sintech/Flip-Dot-Display/(threads)

Thread 1 (2021-03-11):

BAV99 проблема с частями на схеме

Assamber, 2021-03-11:
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

Если обратить внимание на подписи пинов у диодов на схеме, то можно заметить проблему. Пин номер 3 у части A и B один и тот же. На схеме соединяется пины 1 и 2. Получается, что два диода соединяются паралелльно и на встречу друг другу. Смысл этих диодов тогда пропадает. Подозреваю, что на схеме третий пин должен быть подключен к индуктивности.

sintech, 2021-03-12:
Спасибо, исправил в a9cf7c198e970c73305a8bcc1b656d7e699d6c1c
В kicad библиотеках как раз обновилось УГО для BAV99.

Closed 2021-03-12.
