sintech/Flip-Dot-Display/schematics/Flip-dot_part.sch

## KiCad design schematics/Flip-dot_part.sch (2021-03-12)

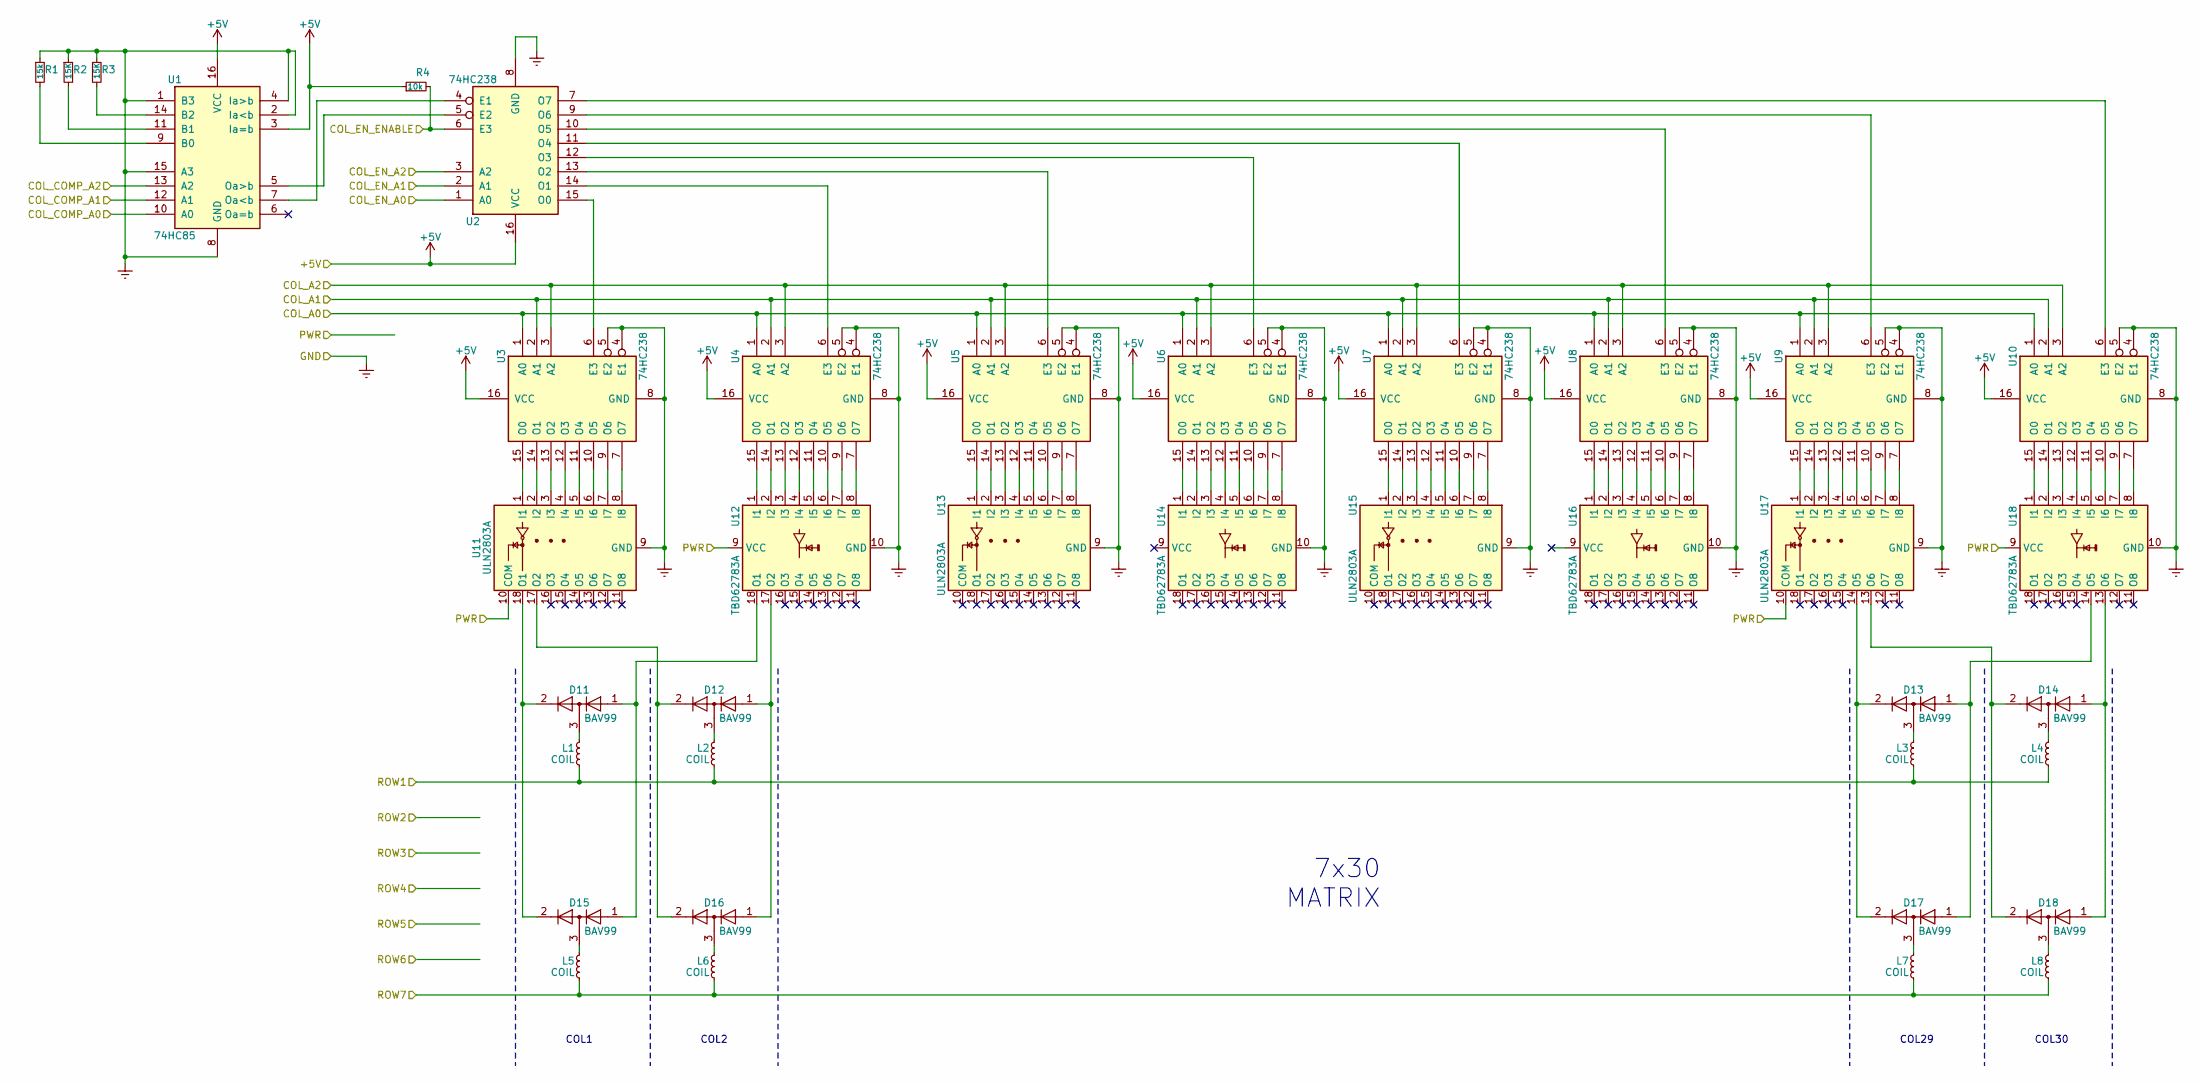
[picture p6: schematic Flip-dot_part.sch]

Parts:
D11, D12, D13, D14, D15, D16, D17, D18: BAV99; SOT-23
L1, L2, L3, L4, L5, L6, L7, L8: COIL
R1: 15k
R2, R3: 15K
R4: 10k
U1: 74HC85
U2, U3, U4, U5, U6, U7, U8, U9, U10: 74HC238
U11, U13, U15, U17: ULN2803A
U12, U14, U16, U18: TBD62783A

Connections:
+5V: R4.1, U1.3 (Ia=b), U1.16 (VCC), U2.16 (VCC), U3.16 (VCC), U4.16 (VCC), U5.16 (VCC), U6.16 (VCC), U7.16 (VCC), U8.16 (VCC), U9.16 (VCC), U10.16 (VCC)
COL_A0: U3.1 (A0), U4.1 (A0), U5.1 (A0), U6.1 (A0), U7.1 (A0), U8.1 (A0), U9.1 (A0), U10.1 (A0)
COL_A1: U3.2 (A1), U4.2 (A1), U5.2 (A1), U6.2 (A1), U7.2 (A1), U8.2 (A1), U9.2 (A1), U10.2 (A1)
COL_A2: U3.3 (A2), U4.3 (A2), U5.3 (A2), U6.3 (A2), U7.3 (A2), U8.3 (A2), U9.3 (A2), U10.3 (A2)
COL_COMP_A0: U1.10 (A0)
COL_COMP_A1: U1.12 (A1)
COL_COMP_A2: U1.13 (A2)
COL_EN_A0: U2.1 (A0)
COL_EN_A1: U2.2 (A1)
COL_EN_A2: U2.3 (A2)
COL_EN_ENABLE: R4.2, U2.6 (E3)
Earth: R1.1, R2.1, R3.1, U1.1 (B3), U1.2 (Ia<b), U1.4 (Ia>b), U1.8 (GND), U1.15 (A3), U2.8 (GND), U3.4 (E1), U3.5 (E2), U3.8 (GND), U4.4 (E1), U4.5 (E2), U4.8 (GND), U5.4 (E1), U5.5 (E2), U5.8 (GND), U6.4 (E1), U6.5 (E2), U6.8 (GND), U7.4 (E1), U7.5 (E2), U7.8 (GND), U8.4 (E1), U8.5 (E2), U8.8 (GND), U9.4 (E1), U9.5 (E2), U9.8 (GND), U10.4 (E1), U10.5 (E2), U10.8 (GND), U11.9 (GND), U12.10 (GND), U13.9 (GND), U14.10 (GND), U15.9 (GND), U16.10 (GND), U17.9 (GND), U18.10 (GND)
unnamed: D11.1 (K), D15.1 (K), U12.18 (O1)
unnamed: D11.2 (A), D15.2 (A), U11.18 (O1)
unnamed: D11.3 (K), L1.1
unnamed: D12.1 (K), D16.1 (K), U12.17 (O2)
unnamed: D12.2 (A), D16.2 (A), U11.17 (O2)
unnamed: D12.3 (K), L2.1
unnamed: D13.1 (K), D17.1 (K), U18.14 (O5)
unnamed: D13.2 (A), D17.2 (A), U17.14 (O5)
unnamed: D13.3 (K), L3.1
unnamed: D14.1 (K), D18.1 (K), U18.13 (O6)
unnamed: D14.2 (A), D18.2 (A), U17.13 (O6)
unnamed: D14.3 (K), L4.1
unnamed: D15.3 (K), L5.1
unnamed: D16.3 (K), L6.1
unnamed: D17.3 (K), L7.1
unnamed: D18.3 (K), L8.1
unnamed: R1.2, U1.9 (B0)
unnamed: R2.2, U1.11 (B1)
unnamed: R3.2, U1.14 (B2)
unnamed: U1.5 (Oa>b), U2.5 (E2)
unnamed: U1.7 (Oa<b), U2.4 (E1)
unnamed: U2.9 (O6), U9.6 (E3)
unnamed: U2.10 (O5), U8.6 (E3)
unnamed: U2.11 (O4), U7.6 (E3)
unnamed: U2.12 (O3), U6.6 (E3)
unnamed: U2.13 (O2), U5.6 (E3)
unnamed: U2.14 (O1), U4.6 (E3)
unnamed: U2.15 (O0), U3.6 (E3)
unnamed: U2.7 (O7), U10.6 (E3)
unnamed: U10.7 (O7), U18.8 (I8)
unnamed: U10.9 (O6), U18.7 (I7)
unnamed: U10.10 (O5), U18.6 (I6)
unnamed: U10.11 (O4), U18.5 (I5)
unnamed: U10.12 (O3), U18.4 (I4)
unnamed: U10.13 (O2), U18.3 (I3)
unnamed: U10.14 (O1), U18.2 (I2)
unnamed: U10.15 (O0), U18.1 (I1)
unnamed: U3.15 (O0), U11.1 (I1)
unnamed: U3.14 (O1), U11.2 (I2)
unnamed: U3.13 (O2), U11.3 (I3)
unnamed: U3.12 (O3), U11.4 (I4)
unnamed: U3.11 (O4), U11.5 (I5)
unnamed: U3.10 (O5), U11.6 (I6)
unnamed: U3.9 (O6), U11.7 (I7)
unnamed: U3.7 (O7), U11.8 (I8)
unnamed: U4.15 (O0), U12.1 (I1)
unnamed: U4.14 (O1), U12.2 (I2)
unnamed: U4.13 (O2), U12.3 (I3)
unnamed: U4.12 (O3), U12.4 (I4)
unnamed: U4.11 (O4), U12.5 (I5)
unnamed: U4.10 (O5), U12.6 (I6)
unnamed: U4.9 (O6), U12.7 (I7)
unnamed: U4.7 (O7), U12.8 (I8)
unnamed: U5.15 (O0), U13.1 (I1)
unnamed: U5.14 (O1), U13.2 (I2)
unnamed: U5.13 (O2), U13.3 (I3)
unnamed: U5.12 (O3), U13.4 (I4)
unnamed: U5.11 (O4), U13.5 (I5)
unnamed: U5.10 (O5), U13.6 (I6)
unnamed: U5.9 (O6), U13.7 (I7)
unnamed: U5.7 (O7), U13.8 (I8)
unnamed: U6.15 (O0), U14.1 (I1)
unnamed: U6.14 (O1), U14.2 (I2)
unnamed: U6.13 (O2), U14.3 (I3)
unnamed: U6.12 (O3), U14.4 (I4)
unnamed: U6.11 (O4), U14.5 (I5)
unnamed: U6.10 (O5), U14.6 (I6)
unnamed: U6.9 (O6), U14.7 (I7)
unnamed: U6.7 (O7), U14.8 (I8)
unnamed: U7.15 (O0), U15.1 (I1)
unnamed: U7.14 (O1), U15.2 (I2)
unnamed: U7.13 (O2), U15.3 (I3)
unnamed: U7.12 (O3), U15.4 (I4)
unnamed: U7.11 (O4), U15.5 (I5)
unnamed: U7.10 (O5), U15.6 (I6)
unnamed: U7.9 (O6), U15.7 (I7)
unnamed: U7.7 (O7), U15.8 (I8)
unnamed: U8.15 (O0), U16.1 (I1)
unnamed: U8.14 (O1), U16.2 (I2)
unnamed: U8.13 (O2), U16.3 (I3)
unnamed: U8.12 (O3), U16.4 (I4)
unnamed: U8.11 (O4), U16.5 (I5)
unnamed: U8.10 (O5), U16.6 (I6)
unnamed: U8.9 (O6), U16.7 (I7)
unnamed: U8.7 (O7), U16.8 (I8)
unnamed: U9.15 (O0), U17.1 (I1)
unnamed: U9.14 (O1), U17.2 (I2)
unnamed: U9.13 (O2), U17.3 (I3)
unnamed: U9.12 (O3), U17.4 (I4)
unnamed: U9.11 (O4), U17.5 (I5)
unnamed: U9.10 (O5), U17.6 (I6)
unnamed: U9.9 (O6), U17.7 (I7)
unnamed: U9.7 (O7), U17.8 (I8)
PWR: U11.10 (COM), U12.9 (VCC), U17.10 (COM), U18.9 (VCC)
ROW1: L1.2, L2.2, L3.2, L4.2
ROW7: L5.2, L6.2, L7.2, L8.2

Notes on the sheet:
COL1
COL2
7x30 MATRIX
COL29
COL30
