sintech/Flip-Dot-Display/schematics/LED_part.sch

## KiCad design schematics/LED_part.sch (2019-05-02)

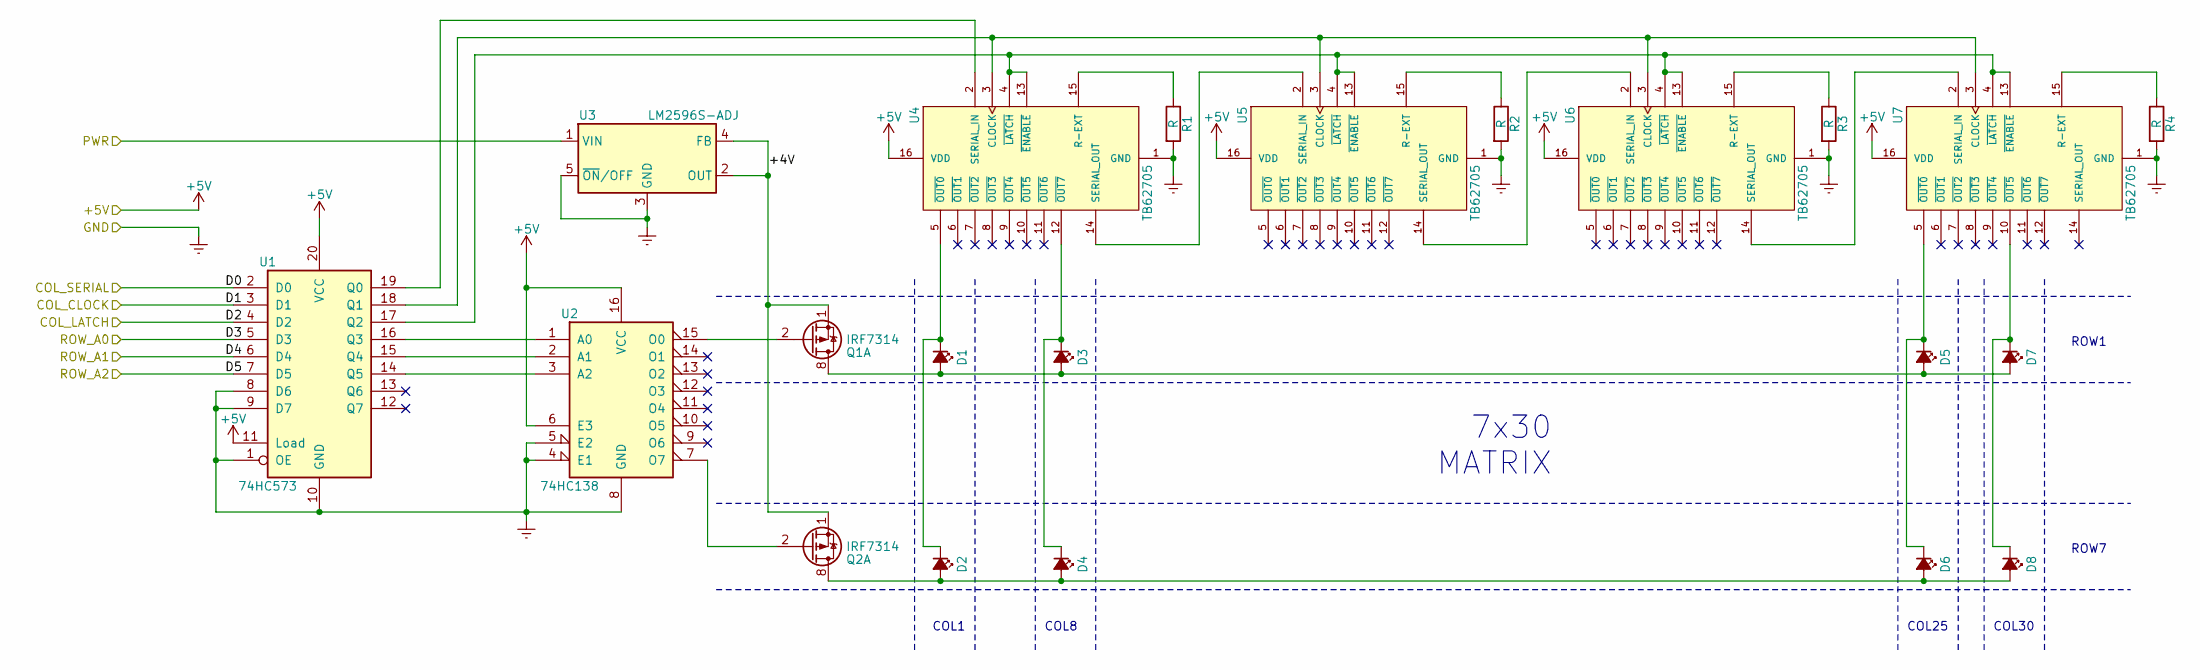
[picture p7: schematic LED_part.sch]

Parts:
D1, D2, D3, D4, D5, D6, D7, D8: LED_Small_ALT
Q1, Q2: IRF7314; SOIC-8_3.9x4.9mm_P1.27mm
R1, R2, R3, R4: R
U1: 74HC573
U2: 74HC138
U3: LM2596S-ADJ; TO-263-5_TabPin3
U4, U5, U6, U7: TB62705

Connections:
+4V: Q1.1 (S1), Q2.1 (S1), U3.2 (OUT), U3.4 (FB)
+5V: U1.11 (Load), U1.20 (VCC), U2.6 (E3), U2.16 (VCC), U4.16 (VDD), U5.16 (VDD), U6.16 (VDD), U7.16 (VDD)
COL_CLOCK: U1.3 (D1)
COL_LATCH: U1.4 (D2)
COL_SERIAL: U1.2 (D0)
D3: U1.5 (D3)
D4: U1.6 (D4)
D5: U1.7 (D5)
Earth: R1.2, R2.2, R3.2, R4.2, U1.1 (OE), U1.8 (D6), U1.9 (D7), U1.10 (GND), U2.4 (E1), U2.5 (E2), U2.8 (GND), U3.3 (GND), U3.5 (~ON~/OFF), U4.1 (GND), U5.1 (GND), U6.1 (GND), U7.1 (GND)
unnamed: D1.1 (K), D2.1 (K), U4.5 (~OUT0)
unnamed: D1.2 (A), D3.2 (A), D5.2 (A), D7.2 (A), Q1.7 (D1), Q1.8 (D1)
unnamed: D2.2 (A), D4.2 (A), D6.2 (A), D8.2 (A), Q2.7 (D1), Q2.8 (D1)
unnamed: D3.1 (K), D4.1 (K), U4.12 (~OUT7)
unnamed: D5.1 (K), D6.1 (K), U7.5 (~OUT0)
unnamed: D7.1 (K), D8.1 (K), U7.10 (~OUT5)
unnamed: Q1.2 (G1), U2.15 (O0)
unnamed: Q2.2 (G1), U2.7 (O7)
unnamed: R1.1, U4.15 (R-EXT)
unnamed: R2.1, U5.15 (R-EXT)
unnamed: R3.1, U6.15 (R-EXT)
unnamed: R4.1, U7.15 (R-EXT)
unnamed: U1.14 (Q5), U2.3 (A2)
unnamed: U1.15 (Q4), U2.2 (A1)
unnamed: U1.16 (Q3), U2.1 (A0)
unnamed: U1.17 (Q2), U4.4 (~LATCH), U4.13 (~ENABLE), U5.4 (~LATCH), U5.13 (~ENABLE), U6.4 (~LATCH), U6.13 (~ENABLE), U7.4 (~LATCH), U7.13 (~ENABLE)
unnamed: U1.18 (Q1), U4.3 (CLOCK), U5.3 (CLOCK), U6.3 (CLOCK), U7.3 (CLOCK)
unnamed: U1.19 (Q0), U4.2 (SERIAL_IN)
unnamed: U4.14 (SERIAL_OUT), U5.2 (SERIAL_IN)
unnamed: U5.14 (SERIAL_OUT), U6.2 (SERIAL_IN)
unnamed: U6.14 (SERIAL_OUT), U7.2 (SERIAL_IN)
PWR: U3.1 (VIN)

Notes on the sheet:
7x30 MATRIX
COL8
COL25
ROW7
ROW1
COL30
COL1
