sintech/Flip-Dot-Display/schematics/flipdotDisplay_adapter.sch

## KiCad design schematics/flipdotDisplay_adapter.sch (2019-05-02)

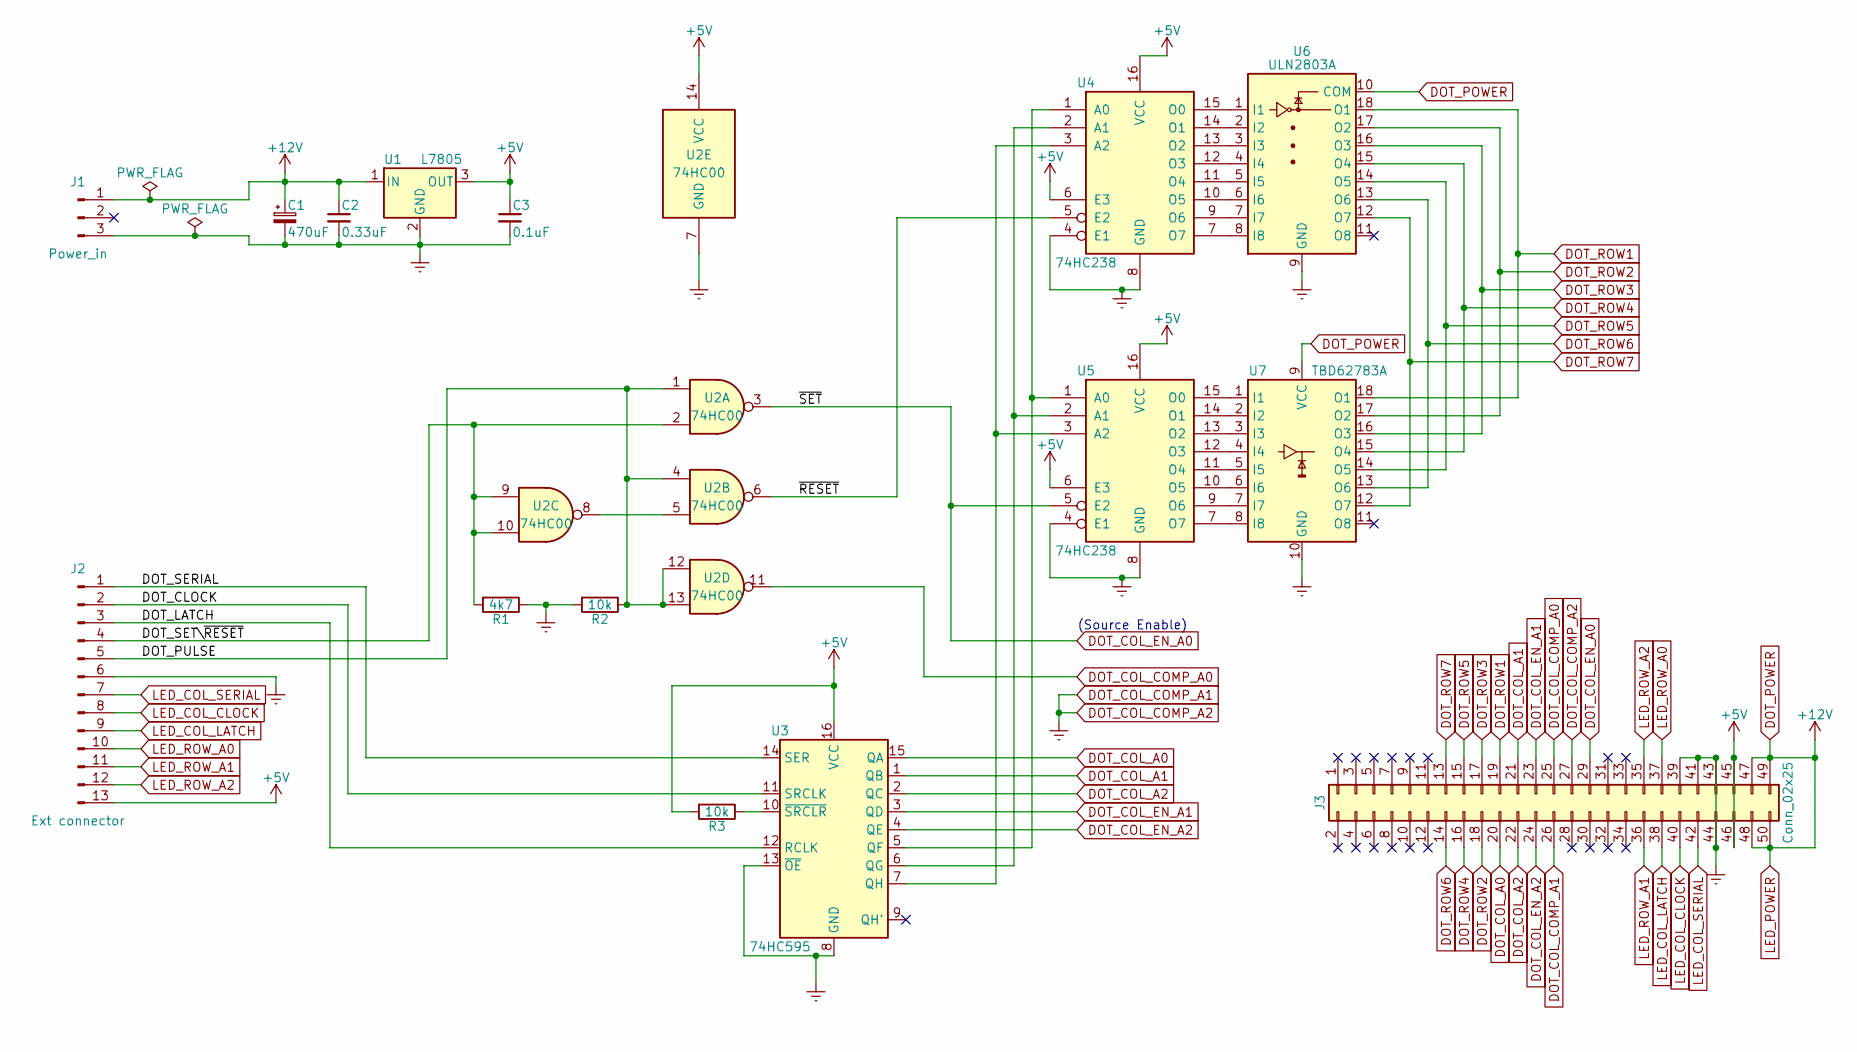
[picture p8: schematic flipdotDisplay_adapter.sch]

Parts:
C1: 470uF
C2: 0.33uF
C3: 0.1uF
J1: Power_in
J2: Ext connector
J3: Conn_02x25; PinHeader_2x25_P2.54mm_Vertical
R1: 4k7
R2, R3: 10k
U1: L7805
U2: 74HC00
U3: 74HC595
U4, U5: 74HC238
U6: ULN2803A
U7: TBD62783A

Connections:
+5V: C3.1, J2.13, J3.45, J3.46, R3.2, U1.3 (OUT), U2.14 (VCC), U3.16 (VCC), U4.6 (E3), U4.16 (VCC), U5.6 (E3), U5.16 (VCC)
+12V: C1.1, C2.1, J1.1, J3.47, J3.48, J3.49, J3.50, U1.1 (IN), U6.10 (COM), U7.9 (VCC)
DOT_CLOCK: J2.2, U3.11 (SRCLK)
DOT_COL_A0: J3.20, U3.15 (QA)
DOT_COL_A1: J3.21, U3.1 (QB)
DOT_COL_A2: J3.22, U3.2 (QC)
DOT_COL_COMP_A0: J3.25, U2.11
DOT_COL_COMP_A1: C1.2, C2.2, C3.2, J1.3, J2.6, J3.26, J3.27, J3.39, J3.41, J3.43, J3.44, R1.1, R2.2, U1.2 (GND), U2.7 (GND), U3.8 (GND), U3.13 (~OE), U4.4 (E1), U4.8 (GND), U5.4 (E1), U5.8 (GND), U6.9 (GND), U7.10 (GND)
DOT_COL_EN_A0: J3.29, U2.3, U5.5 (E2)
DOT_COL_EN_A1: J3.23, U3.3 (QD)
DOT_COL_EN_A2: J3.24, U3.4 (QE)
DOT_LATCH: J2.3, U3.12 (RCLK)
DOT_PULSE: J2.5, R2.1, U2.1, U2.4, U2.12, U2.13
DOT_ROW1: J3.19, U6.18 (O1), U7.18 (O1)
DOT_ROW2: J3.18, U6.17 (O2), U7.17 (O2)
DOT_ROW3: J3.17, U6.16 (O3), U7.16 (O3)
DOT_ROW4: J3.16, U6.15 (O4), U7.15 (O4)
DOT_ROW5: J3.15, U6.14 (O5), U7.14 (O5)
DOT_ROW6: J3.14, U6.13 (O6), U7.13 (O6)
DOT_ROW7: J3.13, U6.12 (O7), U7.12 (O7)
DOT_SERIAL: J2.1, U3.14 (SER)
DOT_SET\~RESET: J2.4, R1.2, U2.2, U2.9, U2.10
LED_COL_CLOCK: J2.8, J3.40
LED_COL_LATCH: J2.9, J3.38
LED_COL_SERIAL: J2.7, J3.42
LED_ROW_A0: J2.10, J3.37
LED_ROW_A1: J2.11, J3.36
LED_ROW_A2: J2.12, J3.35
unnamed: R3.1, U3.10 (~SRCLR)
unnamed: U2.5, U2.8
unnamed: U3.5 (QF), U4.1 (A0), U5.1 (A0)
unnamed: U3.6 (QG), U4.2 (A1), U5.2 (A1)
unnamed: U3.7 (QH), U4.3 (A2), U5.3 (A2)
unnamed: U4.7 (O7), U6.8 (I8)
unnamed: U4.9 (O6), U6.7 (I7)
unnamed: U4.10 (O5), U6.6 (I6)
unnamed: U4.11 (O4), U6.5 (I5)
unnamed: U4.12 (O3), U6.4 (I4)
unnamed: U4.13 (O2), U6.3 (I3)
unnamed: U4.14 (O1), U6.2 (I2)
unnamed: U4.15 (O0), U6.1 (I1)
unnamed: U5.7 (O7), U7.8 (I8)
unnamed: U5.9 (O6), U7.7 (I7)
unnamed: U5.10 (O5), U7.6 (I6)
unnamed: U5.11 (O4), U7.5 (I5)
unnamed: U5.12 (O3), U7.4 (I4)
unnamed: U5.13 (O2), U7.3 (I3)
unnamed: U5.14 (O1), U7.2 (I2)
unnamed: U5.15 (O0), U7.1 (I1)
~RESET: U2.6, U4.5 (E2)

Notes on the sheet:
(Source Enable)
