sintech/Flip-Dot-Display/src/flipdot_tetris/pieces.h

// Pieces definition
char pPieces [7 /*kind */ ][4 /* rotation */ ][5 /* horizontal blocks */ ][5 /* vertical blocks */ ] =
{
// Square
  {
   {
    {0, 0, 0, 0, 0},
    {0, 0, 0, 0, 0},
    {0, 0, 2, 1, 0},
    {0, 0, 1, 1, 0},
    {0, 0, 0, 0, 0}
    },
   {
    {0, 0, 0, 0, 0},
    {0, 0, 0, 0, 0},
    {0, 0, 2, 1, 0},
    {0, 0, 1, 1, 0},
    {0, 0, 0, 0, 0}
    },
   {
    {0, 0, 0, 0, 0},
    {0, 0, 0, 0, 0},
    {0, 0, 2, 1, 0},
    {0, 0, 1, 1, 0},
    {0, 0, 0, 0, 0}
    },
   {
    {0, 0, 0, 0, 0},
    {0, 0, 0, 0, 0},
    {0, 0, 2, 1, 0},
    {0, 0, 1, 1, 0},
    {0, 0, 0, 0, 0}
    }
   },
 
// I
  {
   {
    {0, 0, 0, 0, 0},
    {0, 0, 0, 0, 0},
    {0, 1, 2, 1, 1},
    {0, 0, 0, 0, 0},
    {0, 0, 0, 0, 0}
    },
   {
    {0, 0, 0, 0, 0},
    {0, 0, 1, 0, 0}, 
    {0, 0, 2, 0, 0},
    {0, 0, 1, 0, 0},
    {0, 0, 1, 0, 0}
    },
   {
    {0, 0, 0, 0, 0},
    {0, 0, 0, 0, 0},
    {1, 1, 2, 1, 0},
    {0, 0, 0, 0, 0},
    {0, 0, 0, 0, 0}
    },
   {
    {0, 0, 1, 0, 0},
    {0, 0, 1, 0, 0},
    {0, 0, 2, 0, 0},
    {0, 0, 1, 0, 0},
    {0, 0, 0, 0, 0}
    }
   }
  ,
// L
  {
   {
    {0, 0, 0, 0, 0},
    {0, 0, 1, 0, 0},
    {0, 0, 2, 0, 0},
    {0, 0, 1, 1, 0},
    {0, 0, 0, 0, 0}
    },
   {
    {0, 0, 0, 0, 0},
    {0, 0, 0, 0, 0},
    {0, 1, 2, 1, 0},
    {0, 1, 0, 0, 0},
    {0, 0, 0, 0, 0}
    },
   {
    {0, 0, 0, 0, 0},
    {0, 1, 1, 0, 0},
    {0, 0, 2, 0, 0},
    {0, 0, 1, 0, 0},
    {0, 0, 0, 0, 0}
    },
   {
    {0, 0, 0, 0, 0},
    {0, 0, 0, 1, 0},
    {0, 1, 2, 1, 0},
    {0, 0, 0, 0, 0},
    {0, 0, 0, 0, 0}
    }
   },
// L mirrored
  {
   {
    {0, 0, 0, 0, 0},
    {0, 0, 1, 0, 0},
    {0, 0, 2, 0, 0},
    {0, 1, 1, 0, 0},
    {0, 0, 0, 0, 0}
    },
   {
    {0, 0, 0, 0, 0},
    {0, 1, 0, 0, 0},
    {0, 1, 2, 1, 0},
    {0, 0, 0, 0, 0},
    {0, 0, 0, 0, 0}
    },
   {
    {0, 0, 0, 0, 0},
    {0, 0, 1, 1, 0},
    {0, 0, 2, 0, 0},
    {0, 0, 1, 0, 0},
    {0, 0, 0, 0, 0}
    },
   {
    {0, 0, 0, 0, 0},
    {0, 0, 0, 0, 0},
    {0, 1, 2, 1, 0},
    {0, 0, 0, 1, 0},
    {0, 0, 0, 0, 0}
    }
   },
// N
  {
   {
    {0, 0, 0, 0, 0},
    {0, 0, 0, 1, 0},
    {0, 0, 2, 1, 0},
    {0, 0, 1, 0, 0},
    {0, 0, 0, 0, 0}
    },
   {
    {0, 0, 0, 0, 0},
    {0, 0, 0, 0, 0},
    {0, 1, 2, 0, 0},
    {0, 0, 1, 1, 0},
    {0, 0, 0, 0, 0}
    },
   {
    {0, 0, 0, 0, 0},
    {0, 0, 1, 0, 0},
    {0, 1, 2, 0, 0},
    {0, 1, 0, 0, 0},
    {0, 0, 0, 0, 0}
    },
 
 
 
   {
    {0, 0, 0, 0, 0},
    {0, 1, 1, 0, 0},
    {0, 0, 2, 1, 0},
    {0, 0, 0, 0, 0},
    {0, 0, 0, 0, 0}
    }
   },
// N mirrored
  {
   {
    {0, 0, 0, 0, 0},
    {0, 0, 1, 0, 0},
    {0, 0, 2, 1, 0},
    {0, 0, 0, 1, 0},
    {0, 0, 0, 0, 0}
    },
   {
    {0, 0, 0, 0, 0},
    {0, 0, 0, 0, 0},
    {0, 0, 2, 1, 0},
    {0, 1, 1, 0, 0},
    {0, 0, 0, 0, 0}
    },
   {
    {0, 0, 0, 0, 0},
    {0, 1, 0, 0, 0},
    {0, 1, 2, 0, 0},
    {0, 0, 1, 0, 0},
    {0, 0, 0, 0, 0}
    },
   {
    {0, 0, 0, 0, 0},
    {0, 0, 1, 1, 0},
    {0, 1, 2, 0, 0},
    {0, 0, 0, 0, 0},
    {0, 0, 0, 0, 0}
    }
   },
// T
  {
   {
    {0, 0, 0, 0, 0},
    {0, 0, 1, 0, 0},
    {0, 0, 2, 1, 0},
    {0, 0, 1, 0, 0},
    {0, 0, 0, 0, 0}
    },
   {
    {0, 0, 0, 0, 0},
    {0, 0, 0, 0, 0},
    {0, 1, 2, 1, 0},
    {0, 0, 1, 0, 0},
    {0, 0, 0, 0, 0}
    },
   {
    {0, 0, 0, 0, 0},
    {0, 0, 1, 0, 0},
    {0, 1, 2, 0, 0},
    {0, 0, 1, 0, 0},
    {0, 0, 0, 0, 0}
    },
   {
    {0, 0, 0, 0, 0},
    {0, 0, 1, 0, 0},
    {0, 1, 2, 1, 0},
    {0, 0, 0, 0, 0},
    {0, 0, 0, 0, 0}
    }
   }
};
